jp112sdl/HB-UNI-Sen-POOL/README.md

# HB-UNI-Sen-POOL

### ⚠️ Achtung: RX und TX am FTDI Anschluss sind vertauscht!

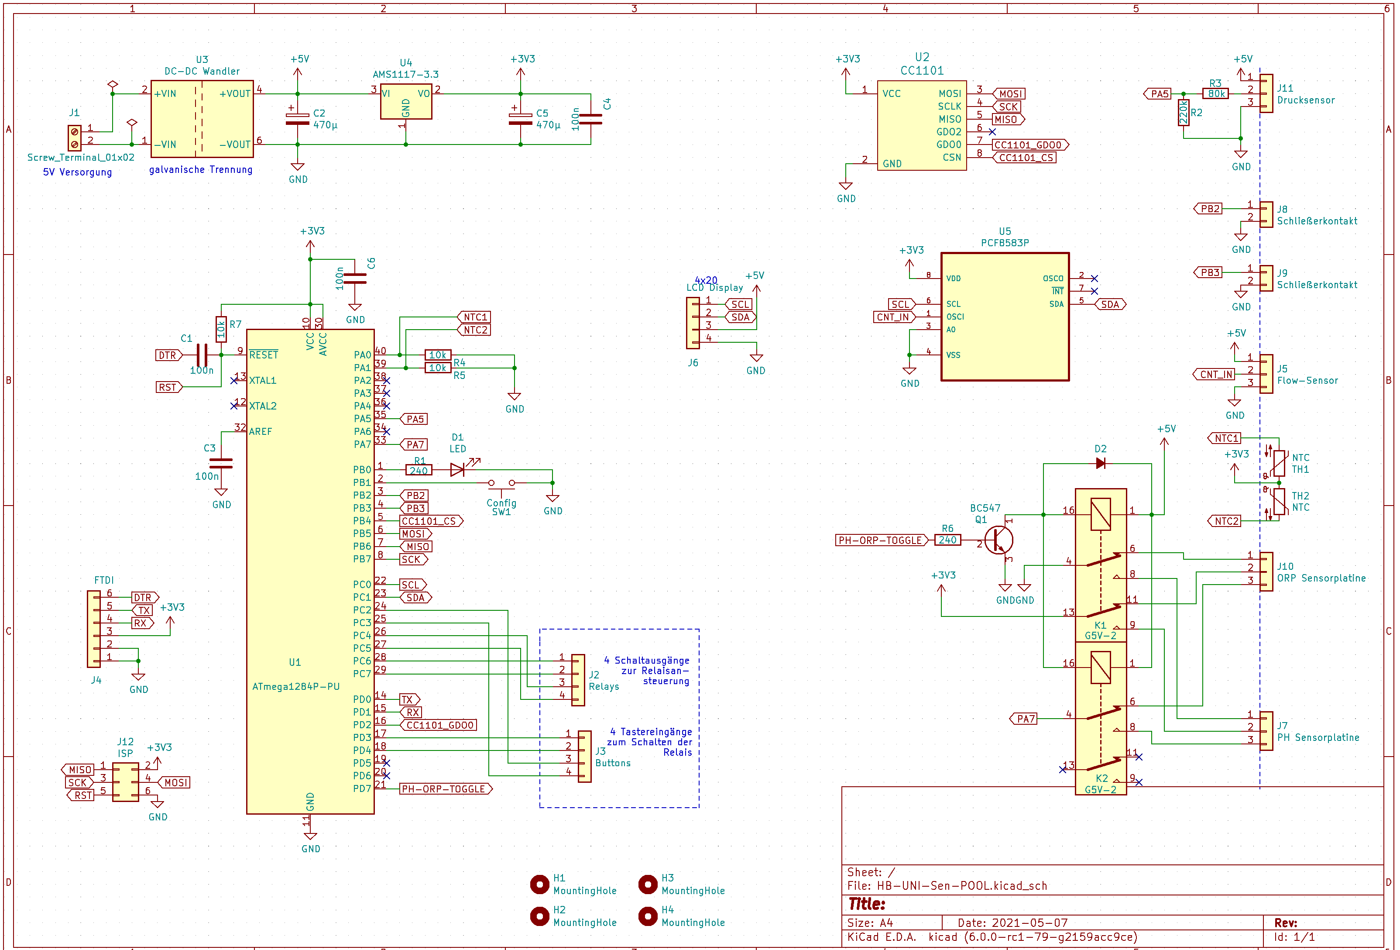
[picture p1: PCB/HB-UNI-Sen-POOL.png]
pcb


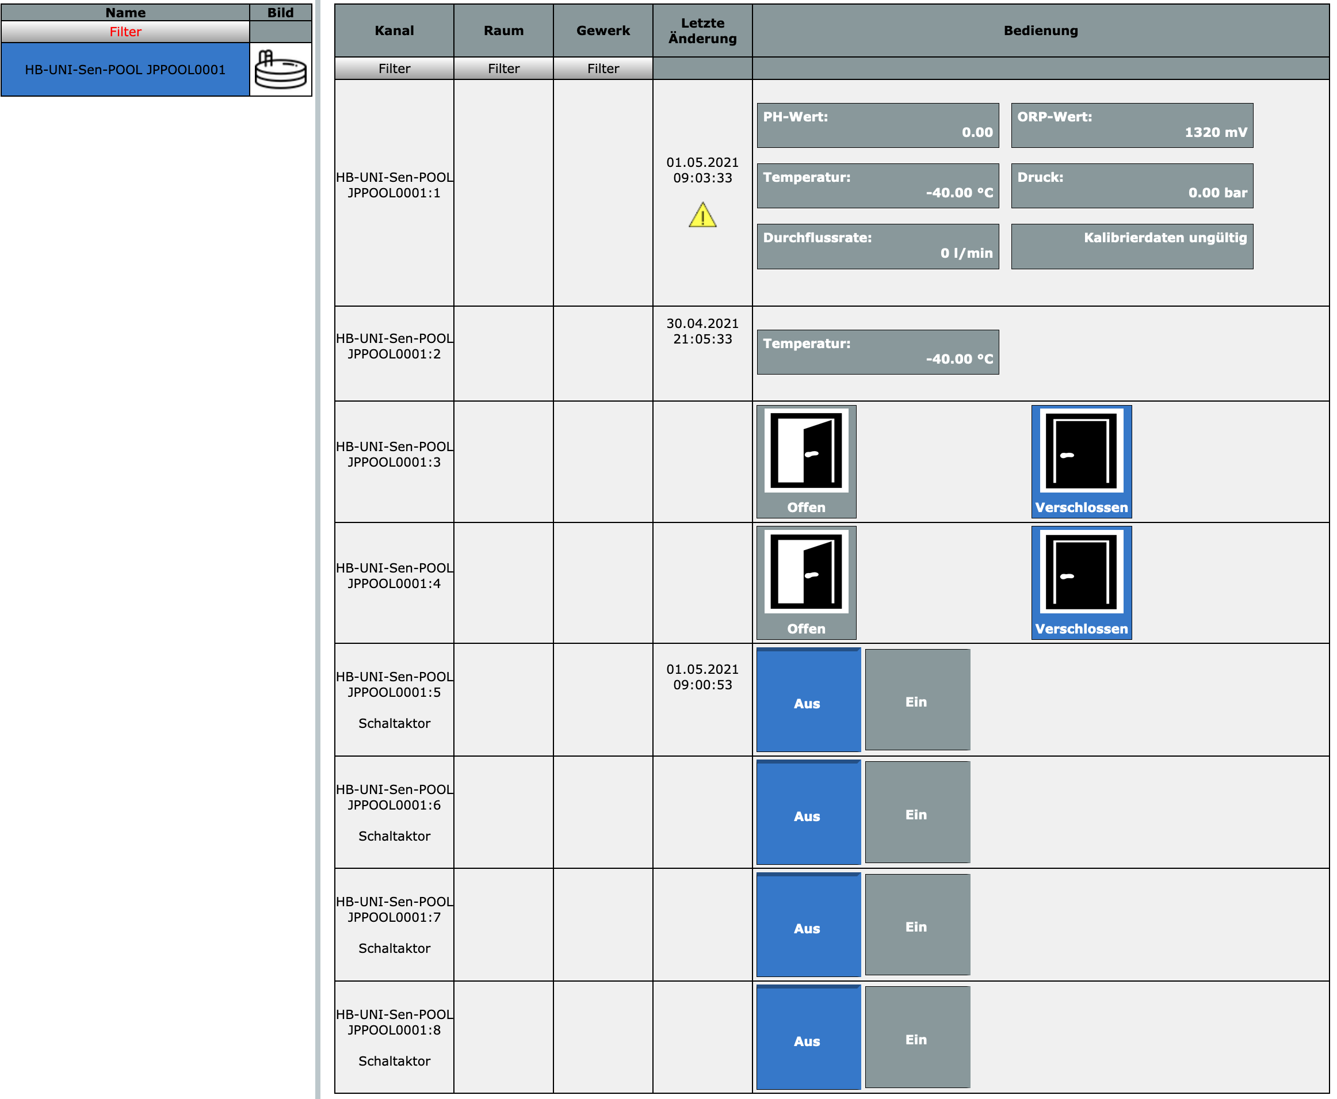
[picture p2: Images/ccu_bedienung.png]


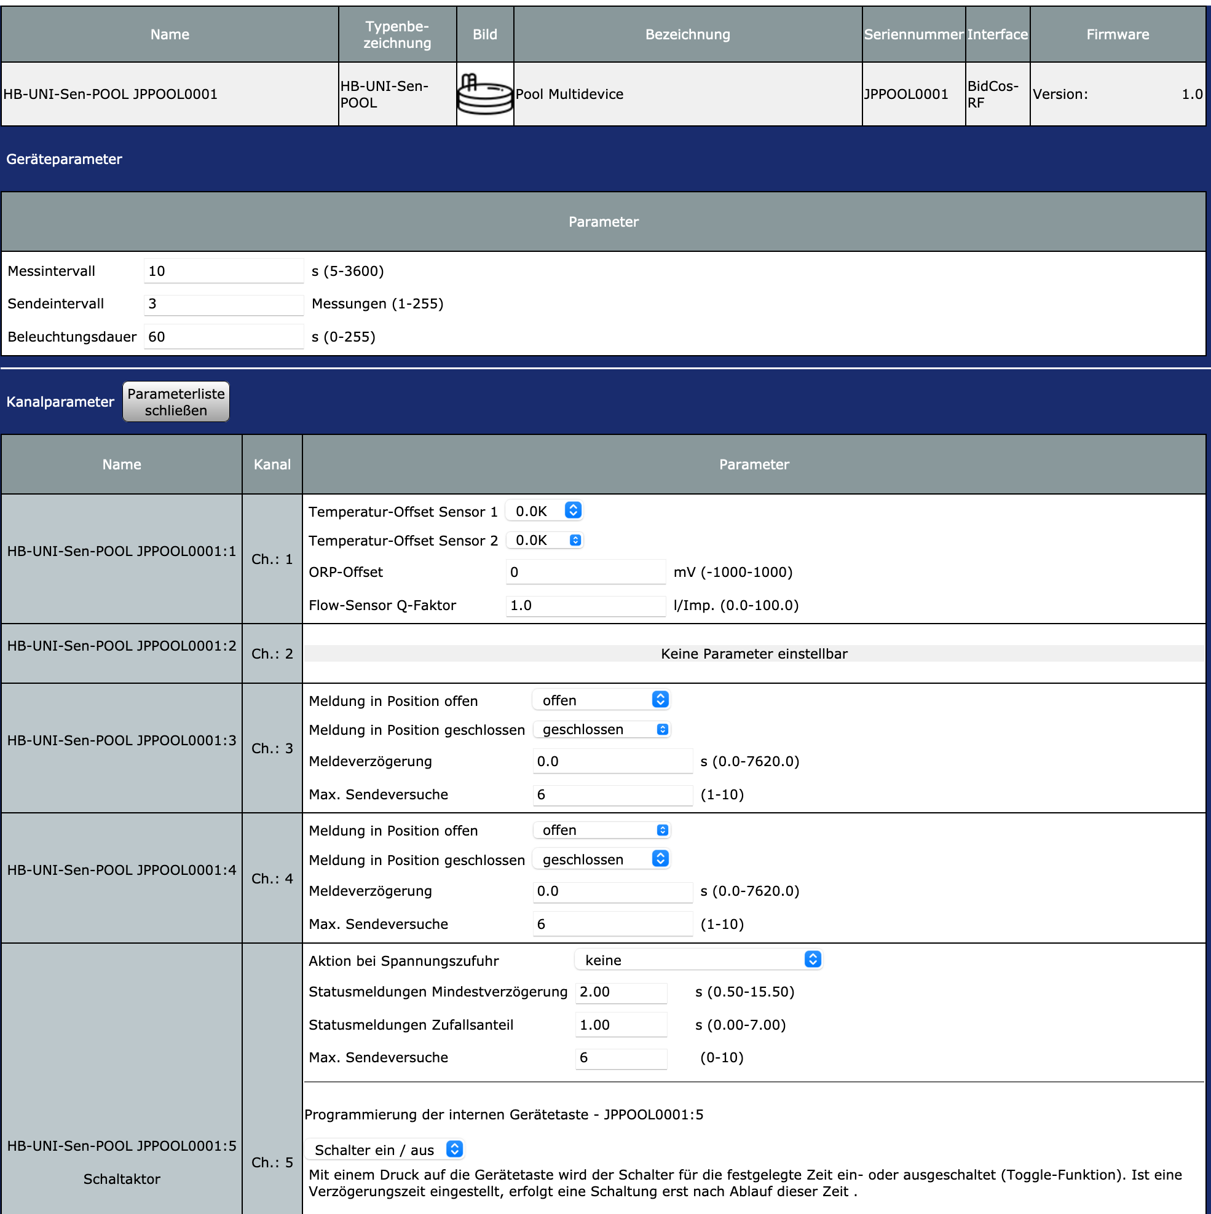
[picture p3: Images/ccu_einstellungen.png]
