jp112sdl/HB-UNI-Sen-POOL/Images/IMG_2311.jpeg

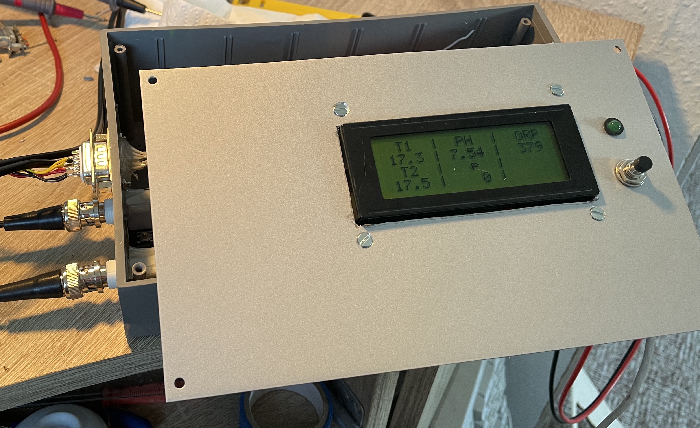
Images/IMG_2311.jpeg
