jp112sdl/HB-UNI-Sen-POOL/Images/IMG_2321.jpeg

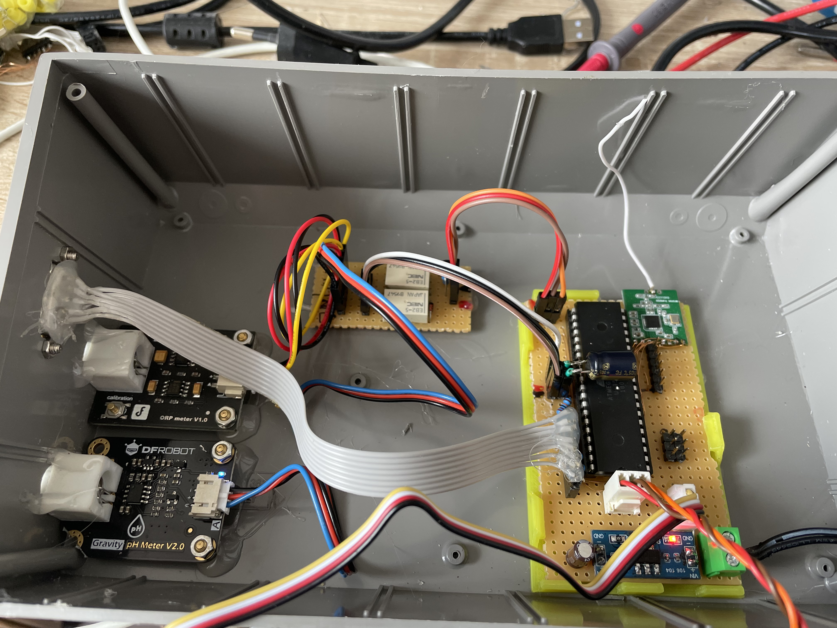
Images/IMG_2321.jpeg
