jp112sdl/HB-UNI-Sen-POOL/PCB/additional/PCF8583P.step

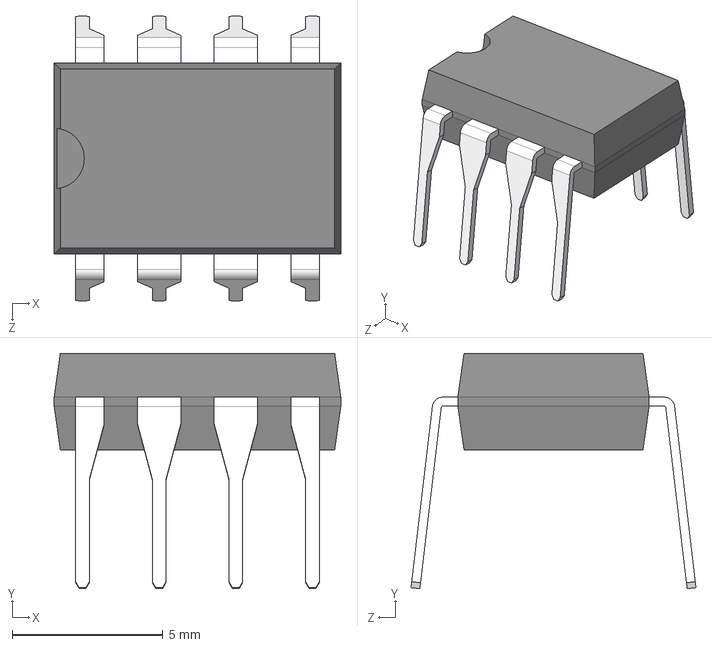
[picture p11: CAD file, 2021-05-07]
PCB/additional/PCF8583P.step
9.50 x 7.80 x 9.44 mm
