jp112sdl/HB-UNI-Sen-POOL/PCB/additional/CC1101_Module.step

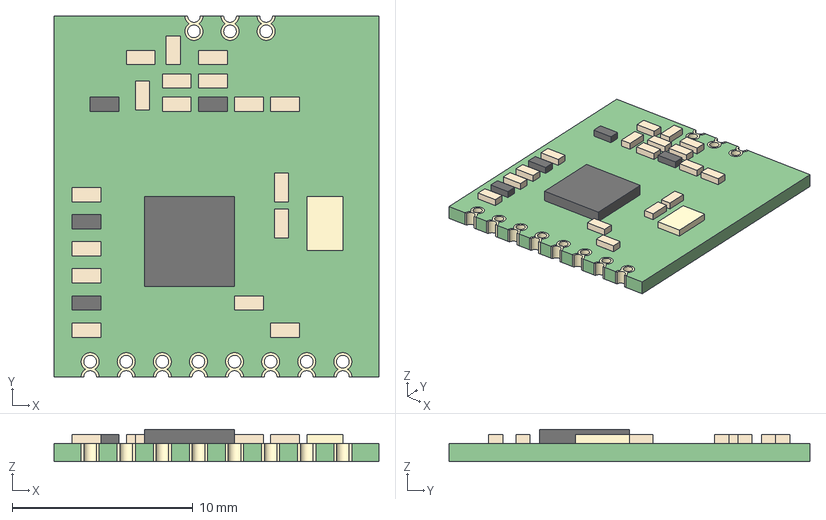
[picture p12: CAD file, 2021-05-07]
PCB/additional/CC1101_Module.step
18.0 x 20.0 x 1.80 mm
PCB
Parts
Pads
