jp112sdl/HB-UNI-Sen-POOL/(threads)

Thread 2 (2024-08-20):

Anfrage: Poolmodul

tritanium73, 2024-08-20:
Hallo Jérome,

dein Projekt "Pool Multimodul" ist der Hammer.

Was muss ich tun, um in den genuß einer "solche Platine" bzw. Gerät zu kommen"??

Da ich nicht sehr bewandert bin in Sachen Elektronik, würde ich das gerne, wenn möglich, bei dir Bestellen :-) das ich ggfs. nur noch die Sensoren anschliessen müsste.
Die Sensoren könnte ich mir ja auf Empfehlung deinerseits dann ja bestellen. Derzeit verwende ich eine CCU3 mit der aktuellsten Raspberrymatic und dein "JP-HB-Devices-addon" in V6.1 habe ich bereits installiert, das läuft....

Wäre toll, wenn du mir mal Infos zukommen lassen könntest, oder dich dazu einmal melden würdest

Danke und einen lieben Gruß ... Micha

jp112sdl, 2024-08-21:
Hi,

ich habe keine Platinen, sondern nur den Schaltplan gezeichnet.

Mein eigener Aufbau befindet sich auch nur auf einer Lochrasterplatine... :)

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

sickboy2711, 2024-08-21:
Ich habe noch Platinen und Bauteile, schreib mich doch im HM-Forum per PN an
