jp112sdl/HB-UNI-Sen-POOL/PCB/HB-UNI-Sen-POOL.pdf

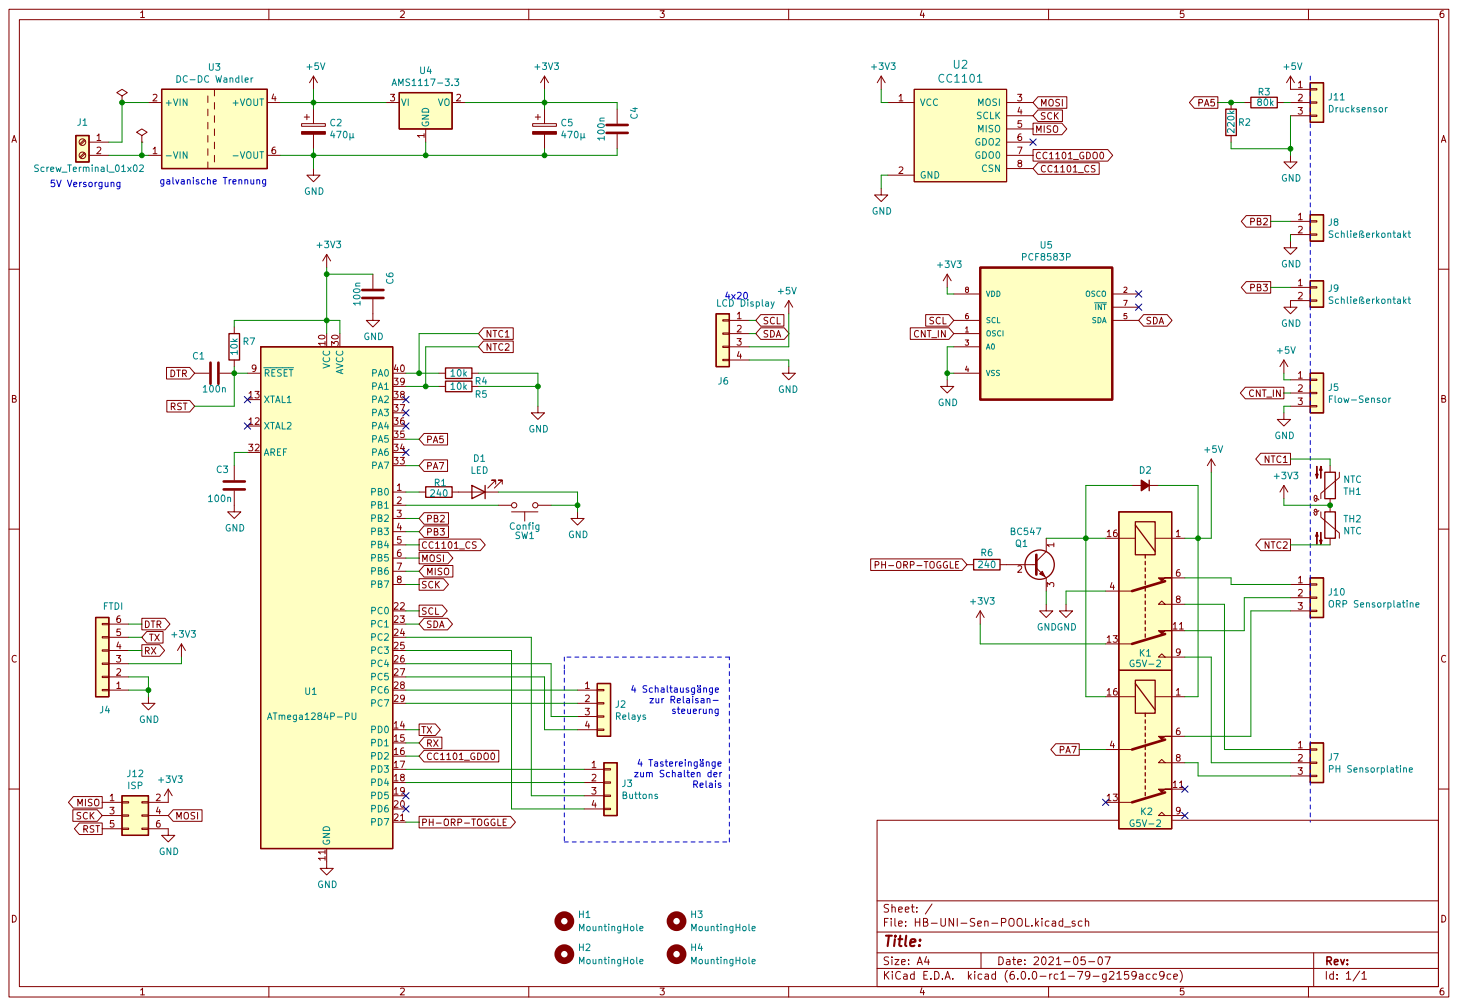
[picture p13: page 1]

zum Schalten der Relais þÿ4 Schaltausgänge
zur Relaisan- steuerung

TXRX | 3
