jp112sdl/HB-UNI-Sen-POOL/PCB/HB-UNI-Sen-POOL.kicad_pcb

## KiCad design PCB/HB-UNI-Sen-POOL.kicad_pcb (2021-11-22)

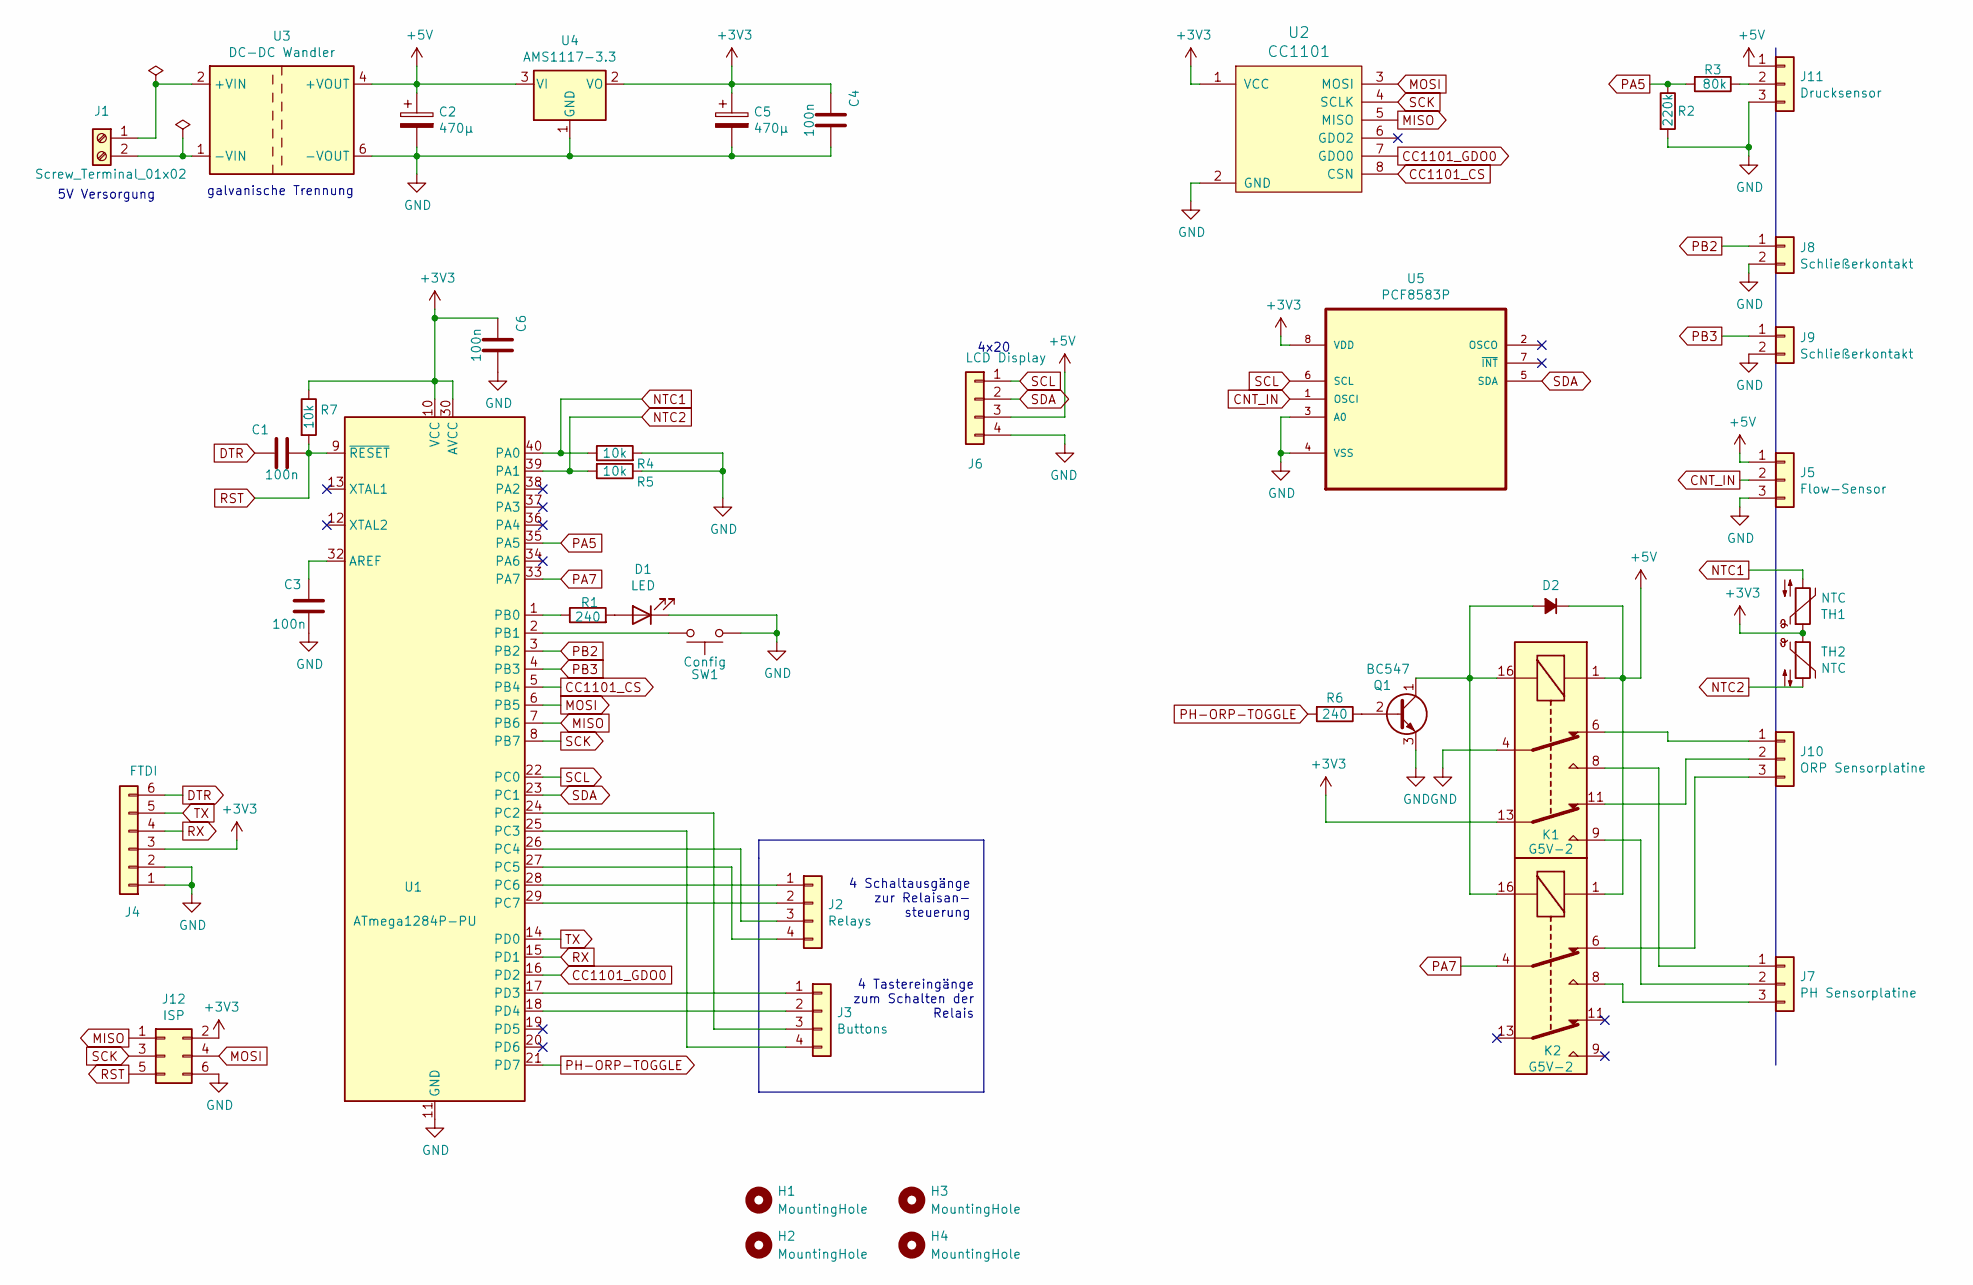
[picture p14: schematic HB-UNI-Sen-POOL.kicad_sch]

Parts:
C1, C3, C4, C6: 100n; C_Rect_L10.0mm_W2.5mm_P7.50mm_MKS4
C2, C5: 470µ; CP_Radial_D8.0mm_P3.50mm
D1: LED; LED_D5.0mm
D2: D_Small_ALT; D_DO-35_SOD27_P7.62mm_Horizontal
H1, H2, H3, H4: MountingHole; MountingHole_2.5mm_Pad
J1: Screw_Terminal_01x02; PhoenixContact_MSTBA_2,5_2-G-5,08_1x02_P5.08mm_Horizontal
J2: Relays; PinHeader_1x04_P2.54mm_Vertical
J3: Buttons; PinHeader_1x04_P2.54mm_Vertical
J4: FTDI; PinHeader_1x06_P2.54mm_Vertical
J5: Flow-Sensor; PinHeader_1x03_P2.54mm_Vertical
J6: LCD Display; PinHeader_1x04_P2.54mm_Vertical
J7: PH Sensorplatine; PinHeader_1x03_P2.54mm_Vertical
J8, J9: Schließerkontakt; PinHeader_1x02_P2.54mm_Vertical
J10: ORP Sensorplatine; PinHeader_1x03_P2.54mm_Vertical
J11: Drucksensor; PinHeader_1x03_P2.54mm_Vertical
J12: ISP; PinHeader_2x03_P2.54mm_Vertical
K1, K2: G5V-2; Relay_DPDT_Omron_G5V-2
Q1: BC547; TO-92_Inline
R1, R6: 240; R_Axial_DIN0207_L6.3mm_D2.5mm_P10.16mm_Horizontal
R2: 220k; R_Axial_DIN0207_L6.3mm_D2.5mm_P10.16mm_Horizontal
R3: 80k; R_Axial_DIN0207_L6.3mm_D2.5mm_P10.16mm_Horizontal
R4, R5, R7: 10k; R_Axial_DIN0207_L6.3mm_D2.5mm_P10.16mm_Horizontal
SW1: Config; SW_PUSH_6mm_H13mm
TH1, TH2: NTC; PinHeader_1x02_P2.54mm_Vertical
U1: ATmega1284P-PU; DIP-40_W15.24mm
U2: CC1101; PinSocket_1x08_P2.00mm_Vertical
U3: DC-DC Wandler; Converter_DCDC_TRACO_TMR-1-xxxx_Single_THT
U4: AMS1117-3.3; SOT-223-3_TabPin2
U5: PCF8583P; DIP254P762X420-8; MPN PCF8583P

Connections:
+3V3: C4.2, C5.1, C6.2, J4.3, J12.2, K1.13, R7.1, TH1.1, TH2.1, U1.10 (VCC), U1.30 (AVCC), U2.1 (VCC), U4.2 (VO), U5.8 (VDD)
+5V: C2.1, D2.1 (K), J5.1, J6.3, J11.1, K1.1, K2.1, U3.4 (+VOUT), U4.3 (VI)
CC1101_CS: U1.5 (PB4), U2.8 (CSN)
CC1101_GDO0: U1.16 (PD2), U2.7 (GDO0)
CNT_IN: J5.2, U5.1 (OSCI)
DTR: C1.2, J4.6
GND: C2.2, C3.1, C4.1, C5.2, C6.1, D1.1 (K), J4.1, J4.2, J5.3, J6.4, J8.2, J9.2, J11.3, J12.6, K1.4, Q1.3 (E), R2.2, R4.2, R5.1, SW1.1, U1.11 (GND), U1.31 (GND), U2.2 (GND), U3.6 (-VOUT), U4.1 (GND), U5.3 (A0), U5.4 (VSS)
MISO: J12.1, U1.7 (PB6), U2.5 (MISO)
MOSI: J12.4, U1.6 (PB5), U2.3 (MOSI)
NTC1: R4.1, TH1.2, U1.40 (PA0)
NTC2: R5.2, TH2.2, U1.39 (PA1)
unnamed: C3.2, U1.32 (AREF)
unnamed: D1.2 (A), R1.2
unnamed: D2.2 (A), K1.16, K2.16, Q1.1 (C)
unnamed: J1.1, U3.2 (+VIN)
unnamed: J1.2, U3.1 (-VIN)
unnamed: J2.1, U1.28 (PC6)
unnamed: J2.2, U1.29 (PC7)
unnamed: J2.3, U1.26 (PC4)
unnamed: J2.4, U1.27 (PC5)
unnamed: J3.1, U1.17 (PD3)
unnamed: J3.2, U1.18 (PD4)
unnamed: J3.3, U1.24 (PC2)
unnamed: J3.4, U1.25 (PC3)
unnamed: J7.1, K1.8
unnamed: J7.2, K1.9
unnamed: J7.3, K2.8
unnamed: J10.1, K1.6
unnamed: J10.2, K1.11
unnamed: J10.3, K2.6
unnamed: J11.2, R3.1
unnamed: Q1.2 (B), R6.1
unnamed: R1.1, U1.1 (PB0)
unnamed: SW1.2, U1.2 (PB1)
PA5: R2.1, R3.2, U1.35 (PA5)
PA7: K2.4, U1.33 (PA7)
PB2: J8.1, U1.3 (PB2)
PB3: J9.1, U1.4 (PB3)
PH-ORP-TOGGLE: R6.2, U1.21 (PD7)
RST: C1.1, J12.5, R7.2, U1.9 (~RESET)
RX: J4.4, U1.15 (PD1)
SCK: J12.3, U1.8 (PB7), U2.4 (SCLK)
SCL: J6.1, U1.22 (PC0), U5.6 (SCL)
SDA: J6.2, U1.23 (PC1), U5.5 (SDA)
TX: J4.5, U1.14 (PD0)

Notes on the sheet:
4 Tastereingänge zum Schalten der Relais
5V Versorgung
galvanische Trennung
4x20
4 Schaltausgänge zur Relaisan- steuerung

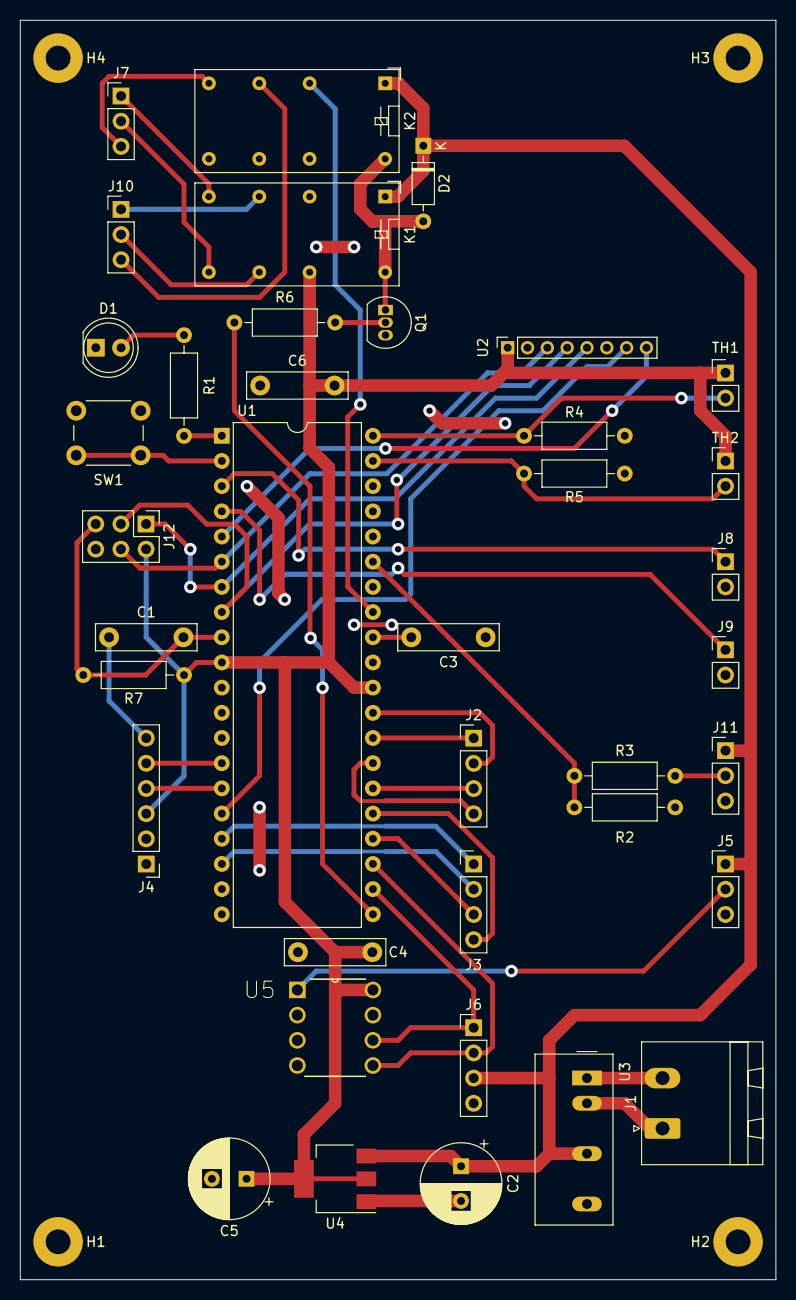
[picture p15: board HB-UNI-Sen-POOL.kicad_pcb from above]

Board: 2 copper layers, 76.2 x 127.0 mm, 42 parts (0 on the bottom side), 45 nets.
