jp112sdl/HB-UNI-Sen-POOL/(commit log)

2021-05-01 show error in ccu when calibration data are invalid
    [HB-UNI-Sen-POOL.ino]
2021-05-03 add relay pin to switch between PH and ORP sensor
2021-05-07 add schematics
    [CC1101_Module.step, HB-UNI-Sen-POOL.kicad_pcb, HB-UNI-Sen-POOL.sch, PCF8583P.step]
2021-05-14 flow measurement
2021-05-17 disable voltage display timer
2021-11-22 Create a simple two layer PCB for this schematic
    Update the schematic with a few minor changes
    revised some footprints
    added one more bypass capacitor C6
    added mounting holes
    Create simple two layer PCB
    ground pour on bottom layer
    [HB-UNI-Sen-POOL.kicad_pcb, HB-UNI-Sen-POOL.kicad_sch]
